bahao113/Xe-tu-hanh-OpenCV/Hinh anh ket qua/chong nhieu ban tay.png

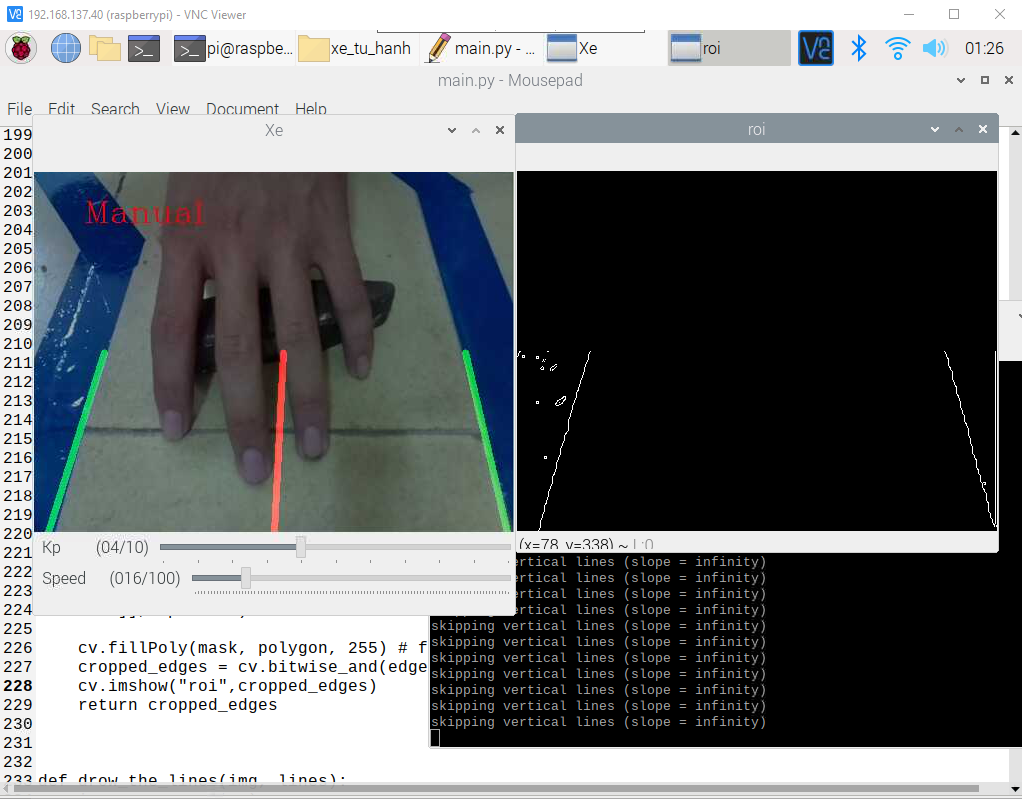
Hinh anh ket qua/chong nhieu ban tay.png
