bahao113/Xe-tu-hanh-OpenCV/Hinh anh ket qua/14bb37ee472dba73e33c.jpg

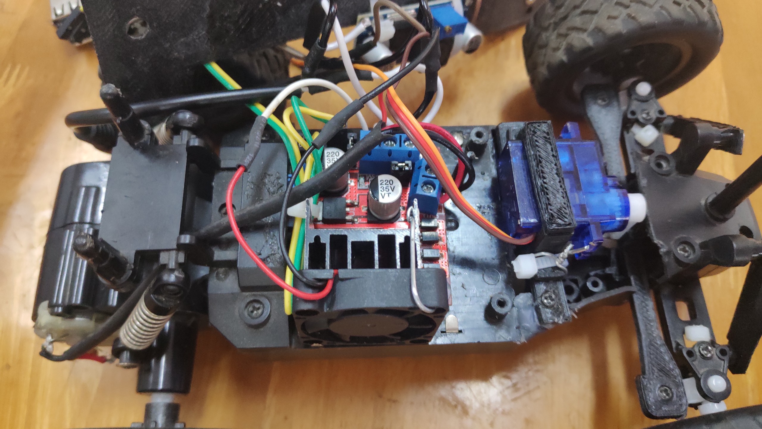
Hinh anh ket qua/14bb37ee472dba73e33c.jpg
