bahao113/Xe-tu-hanh-OpenCV/Hinh anh ket qua/3cb614c564069958c017.jpg

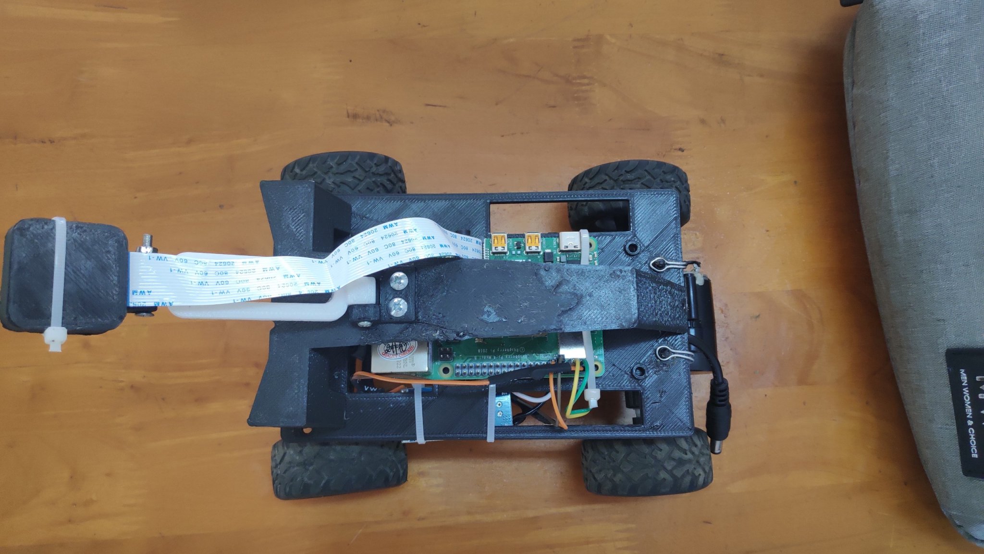
Hinh anh ket qua/3cb614c564069958c017.jpg
