bahao113/Xe-tu-hanh-OpenCV/Hinh anh ket qua/965b1f1d6fde9280cbcf.jpg

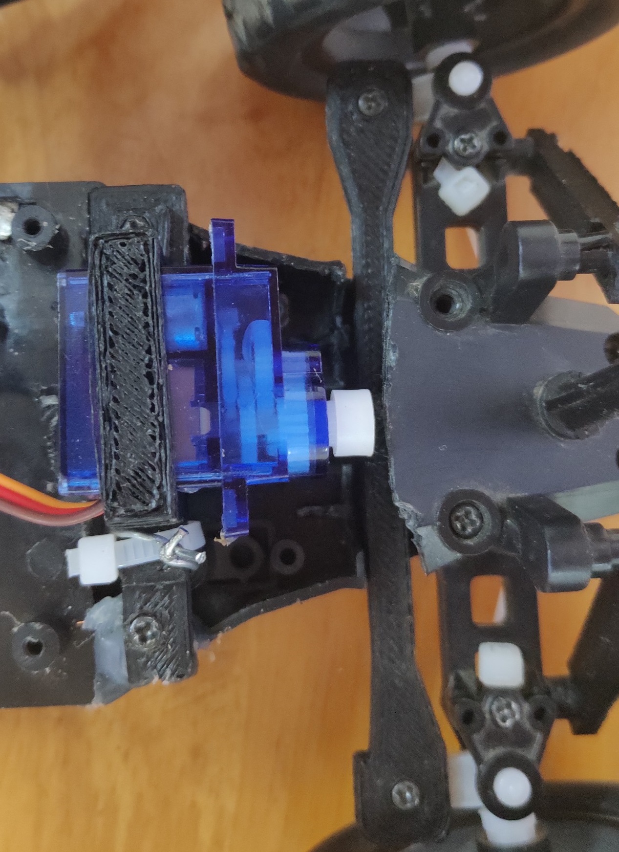
Hinh anh ket qua/965b1f1d6fde9280cbcf.jpg
