bahao113/Xe-tu-hanh-OpenCV/Hinh anh ket qua/chong nhieu.png

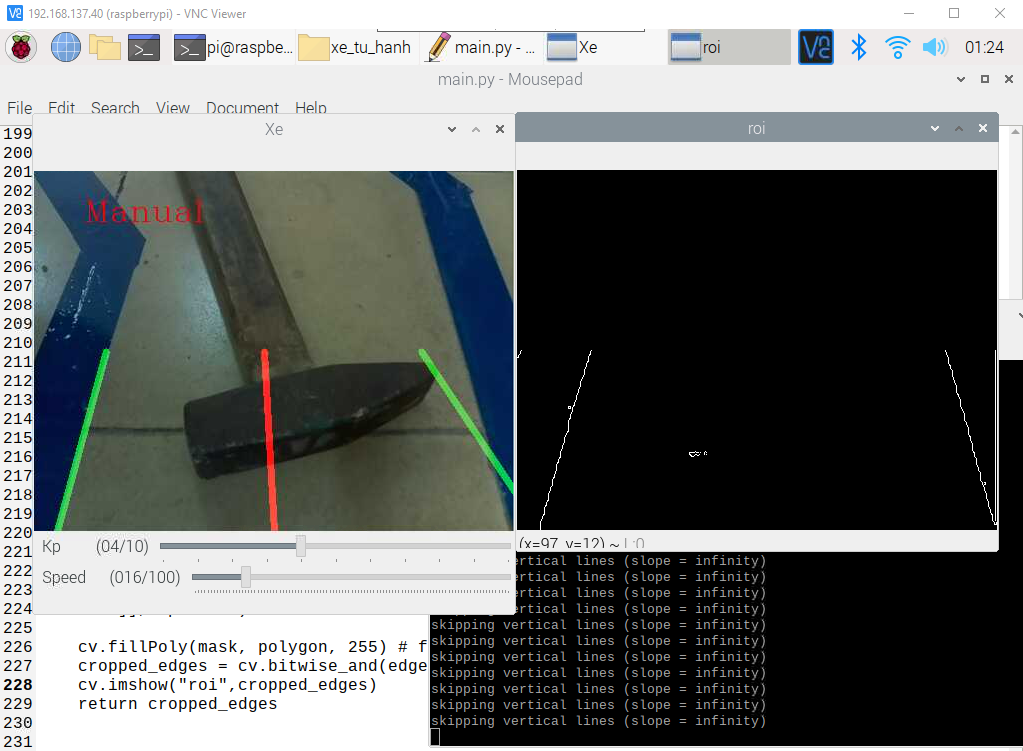
Hinh anh ket qua/chong nhieu.png
