bahao113/Xe-tu-hanh-OpenCV/Hinh anh ket qua/IMG_20200621_121812_1.jpg

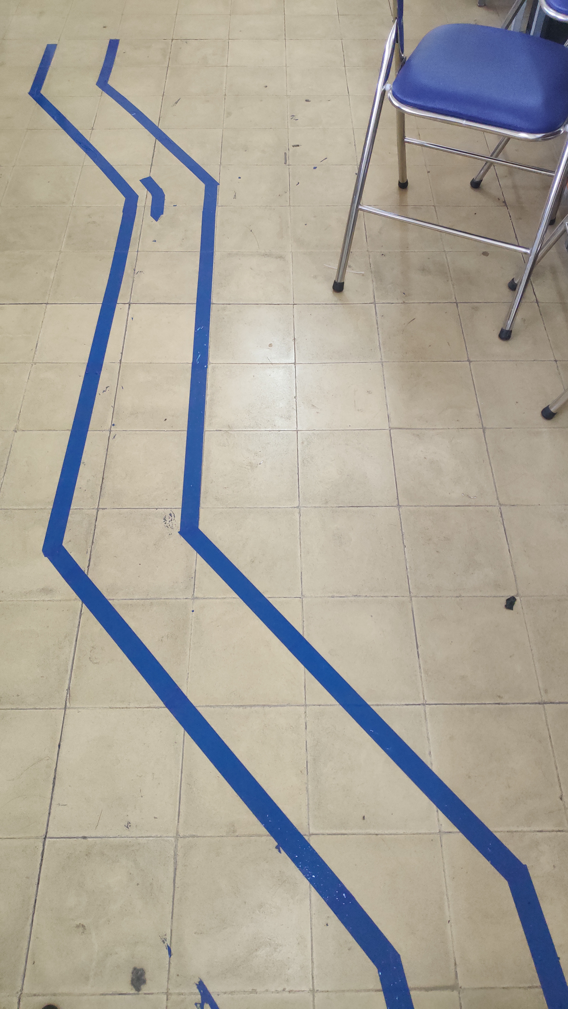
Hinh anh ket qua/IMG_20200621_121812_1.jpg
