bahao113/Xe-tu-hanh-OpenCV/Hinh anh Sketchup/camera_bed.png

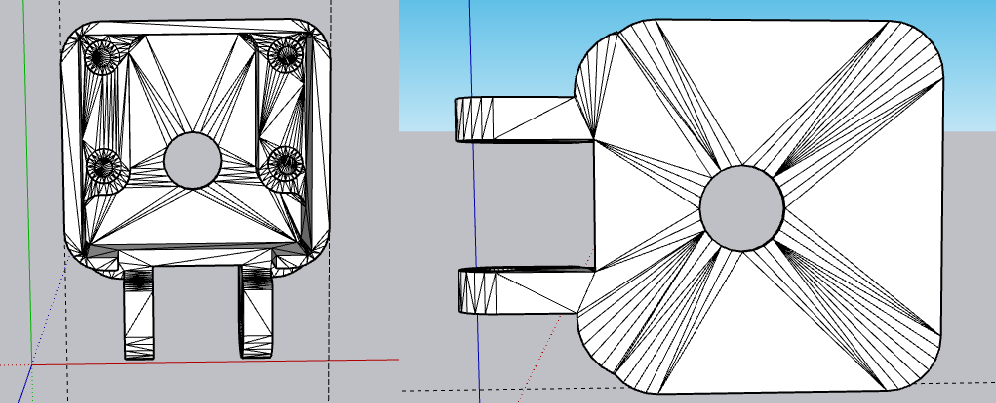
Hinh anh Sketchup/camera_bed.png
