bahao113/Xe-tu-hanh-OpenCV/Hinh anh Sketchup/canny, houghline, drawline.png

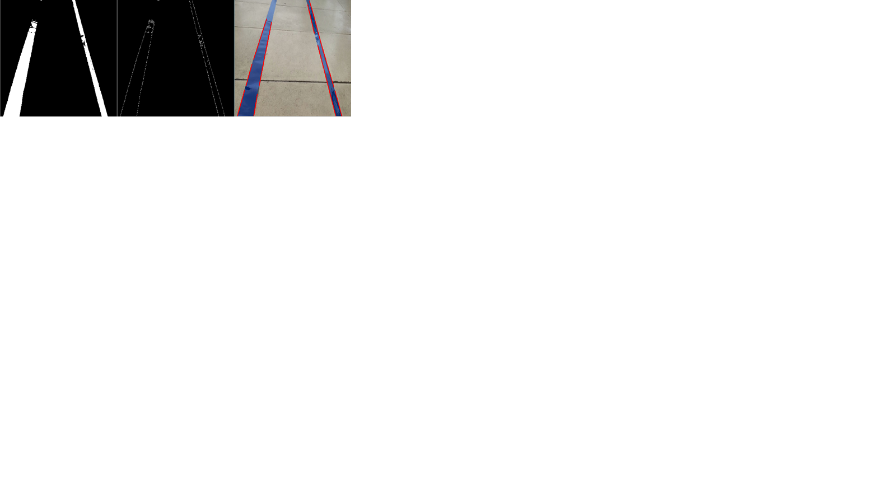
Hinh anh Sketchup/canny, houghline, drawline.png
