bahao113/Xe-tu-hanh-OpenCV/schematic/He thong dien.png

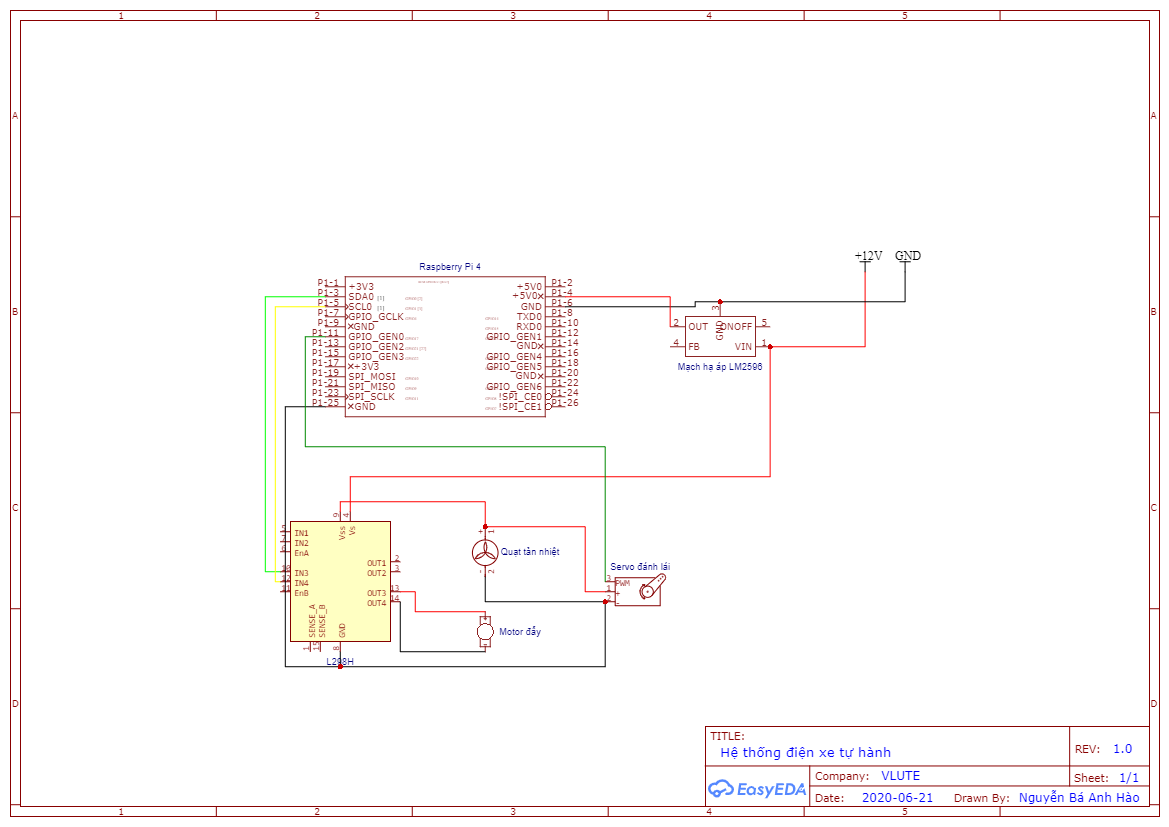
schematic/He thong dien.png
