bahao113/Xe-tu-hanh-OpenCV/schematic/so do.PNG

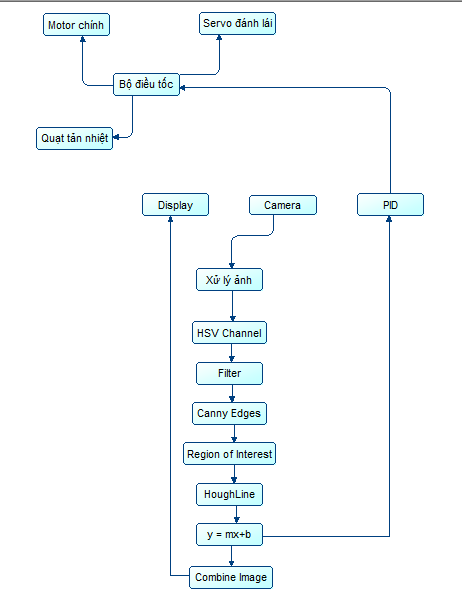
schematic/so do.PNG
