bahao113/Xe-tu-hanh-OpenCV/In 3d/Camera_Mount_Back_Cover.stl

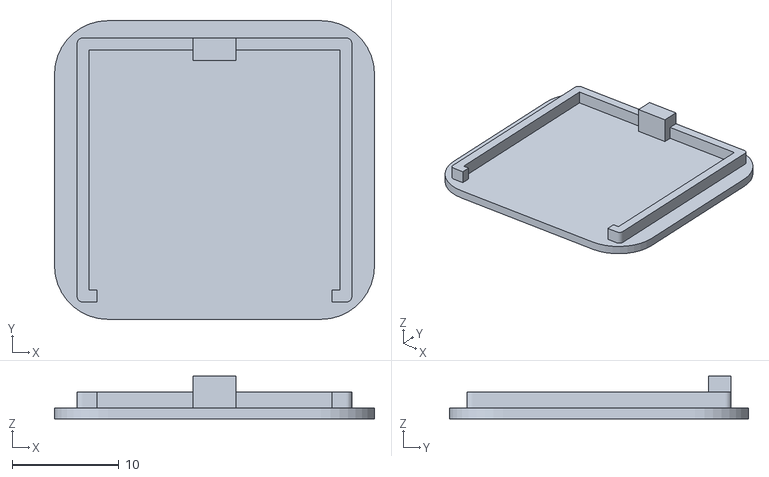
[picture p62: CAD file, 2020-06-21]
In 3d/Camera_Mount_Back_Cover.stl
30.0 x 28.0 x 4.00
