bahao113/Xe-tu-hanh-OpenCV/In 3d/steering bar new.stl

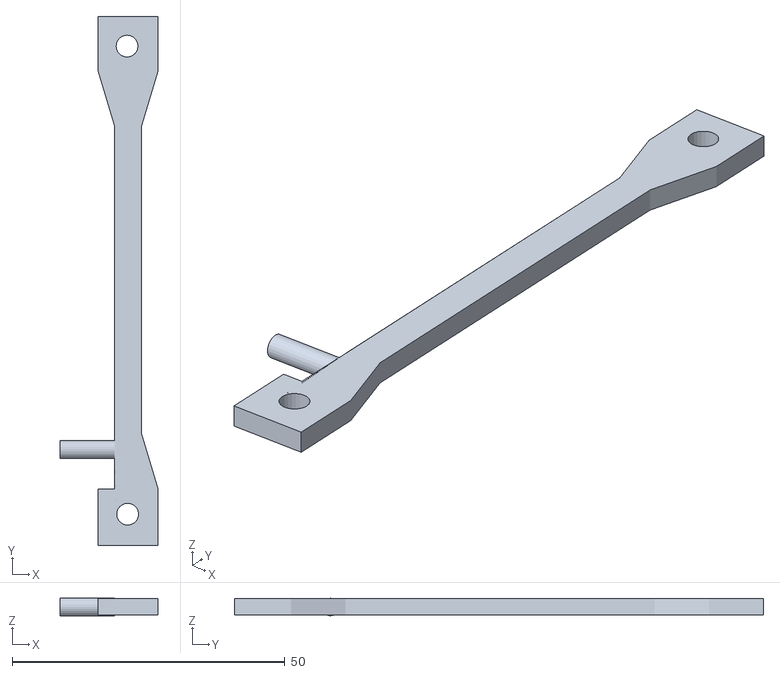
[picture p63: CAD file, 2020-06-21]
In 3d/steering bar new.stl
18.0 x 97.0 x 3.24
