bahao113/Xe-tu-hanh-OpenCV/In 3d/bed servo.stl

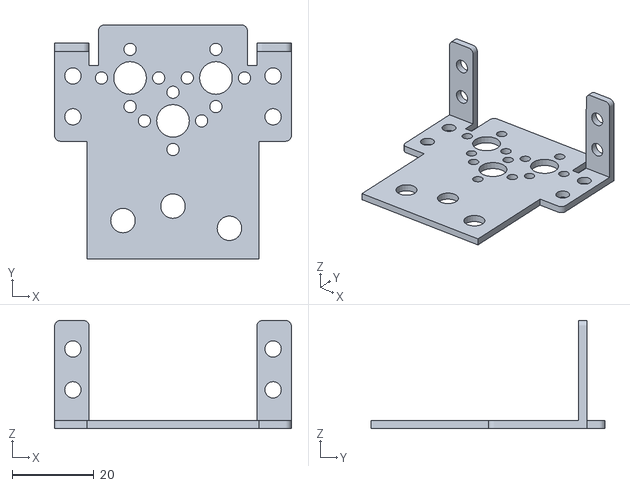
[picture p64: CAD file, 2020-06-21]
In 3d/bed servo.stl
58.0 x 57.3 x 26.5
