bahao113/Xe-tu-hanh-OpenCV/In 3d/Camera_Stand_Base.stl

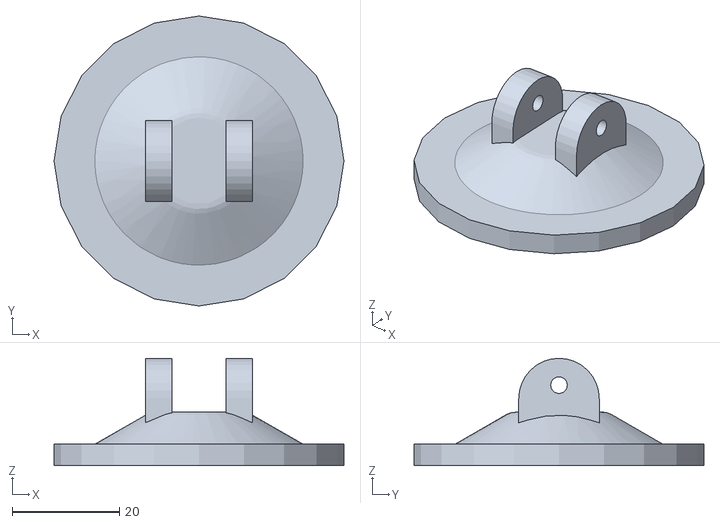
[picture p65: CAD file, 2020-06-21]
In 3d/Camera_Stand_Base.stl
54.0 x 54.0 x 20.0
