bahao113/Xe-tu-hanh-OpenCV/In 3d/test.stl

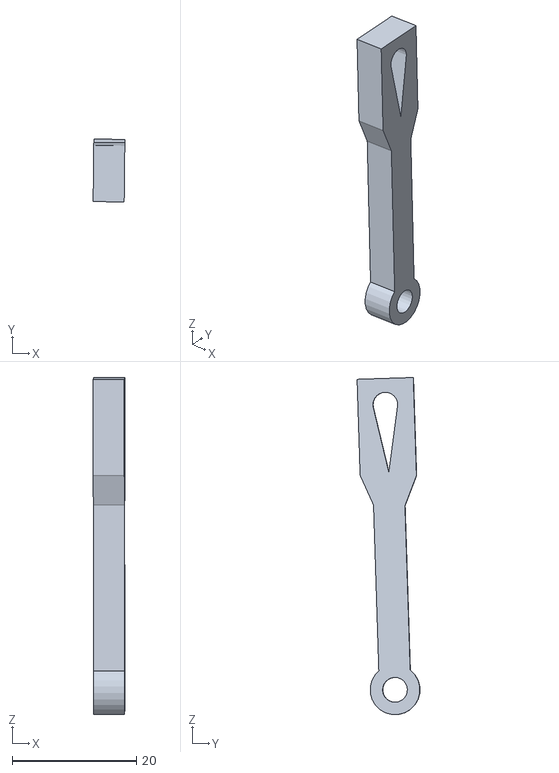
[picture p66: CAD file, 2020-06-21]
In 3d/test.stl
5.11 x 10.1 x 54.2
