bahao113/Xe-tu-hanh-OpenCV/In 3d/khung gan.stl

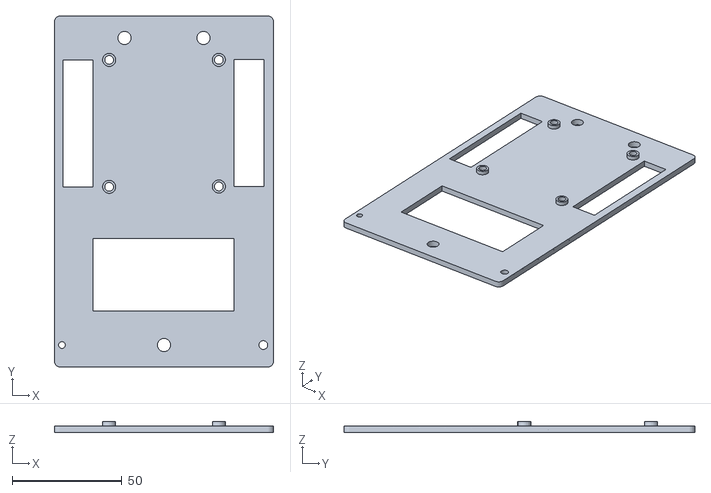
[picture p67: CAD file, 2020-06-21]
In 3d/khung gan.stl
100.0 x 160.0 x 5.00
