bahao113/Xe-tu-hanh-OpenCV/In 3d/new steering bar.stl

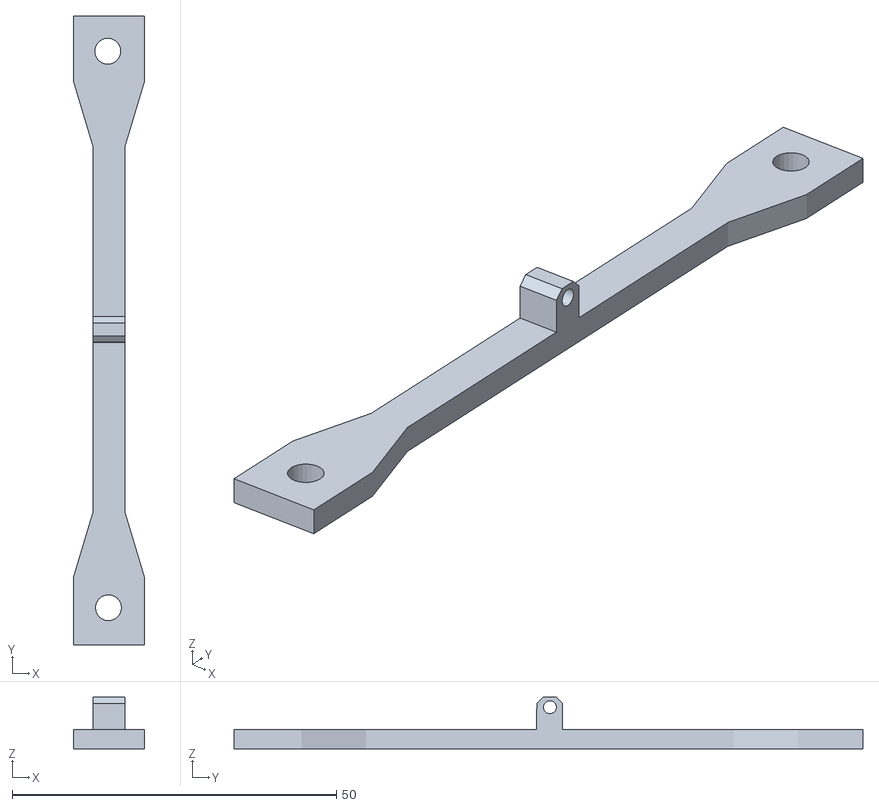
[picture p68: CAD file, 2020-06-21]
In 3d/new steering bar.stl
11.0 x 97.0 x 8.01
