bahao113/Xe-tu-hanh-OpenCV/In 3d/steering bar.stl

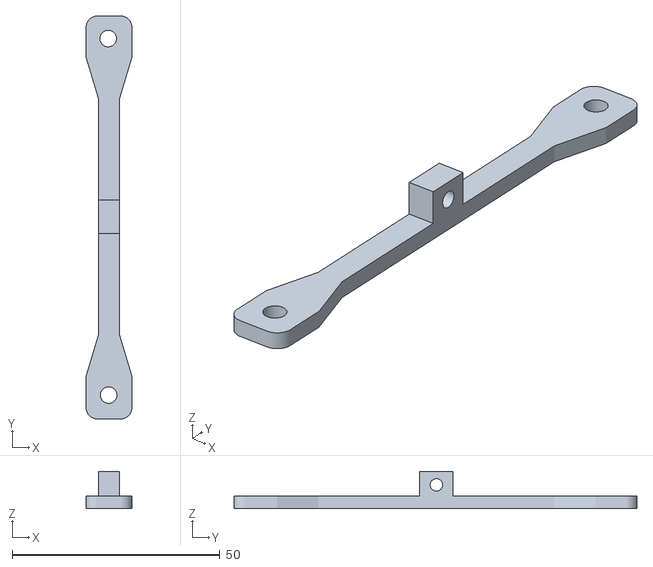
[picture p69: CAD file, 2020-06-21]
In 3d/steering bar.stl
11.0 x 97.0 x 9.01
