bahao113/Xe-tu-hanh-OpenCV/In 3d/Raspberry_PI_Camera_Stand.stl

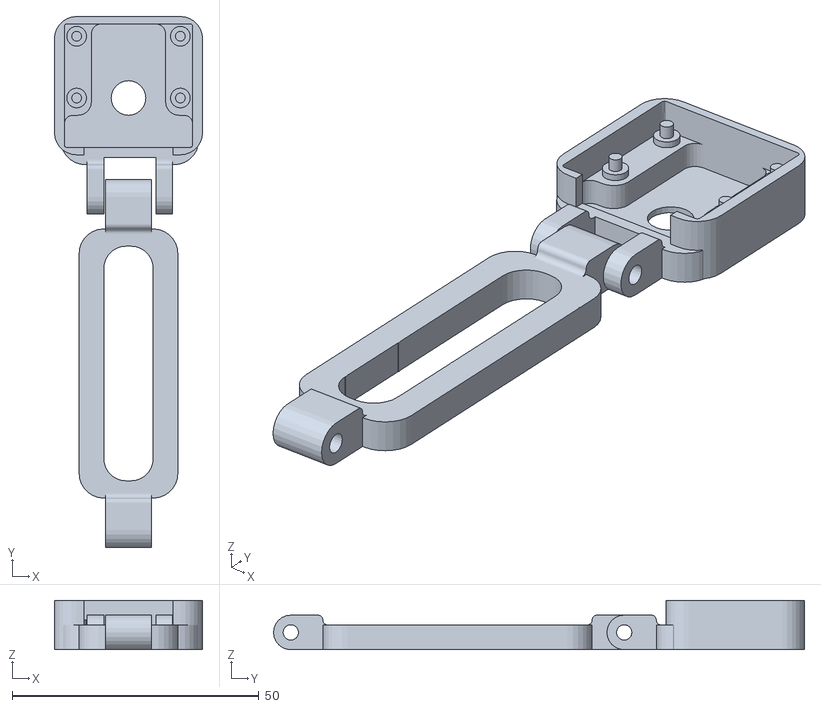
[picture p70: CAD file, 2020-06-21]
In 3d/Raspberry_PI_Camera_Stand.stl
30.0 x 107.5 x 10.0
