bahao113/Xe-tu-hanh-OpenCV/In 3d/nap servor.stl

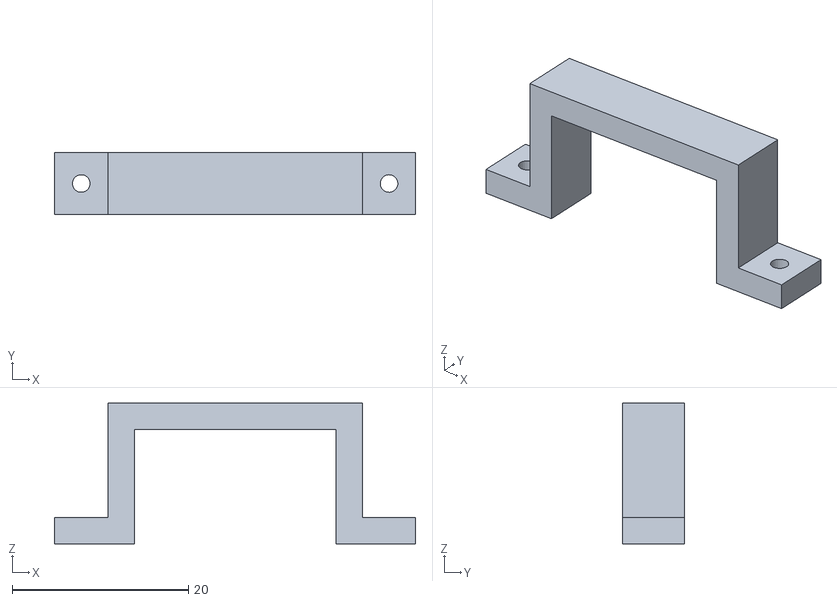
[picture p71: CAD file, 2020-06-21]
In 3d/nap servor.stl
41.0 x 7.00 x 16.0
