bahao113/Xe-tu-hanh-OpenCV/In 3d/piston.stl

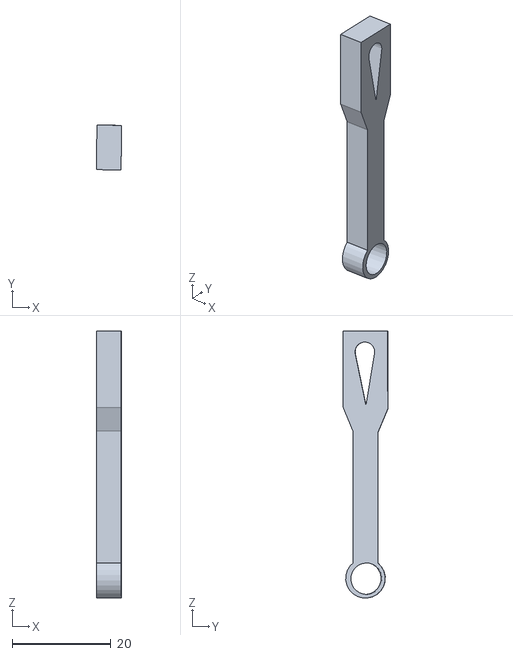
[picture p72: CAD file, 2020-06-21]
In 3d/piston.stl
5.10 x 9.09 x 54.1
