bahao113/Xe-tu-hanh-OpenCV/In 3d/pi camera bed.stl

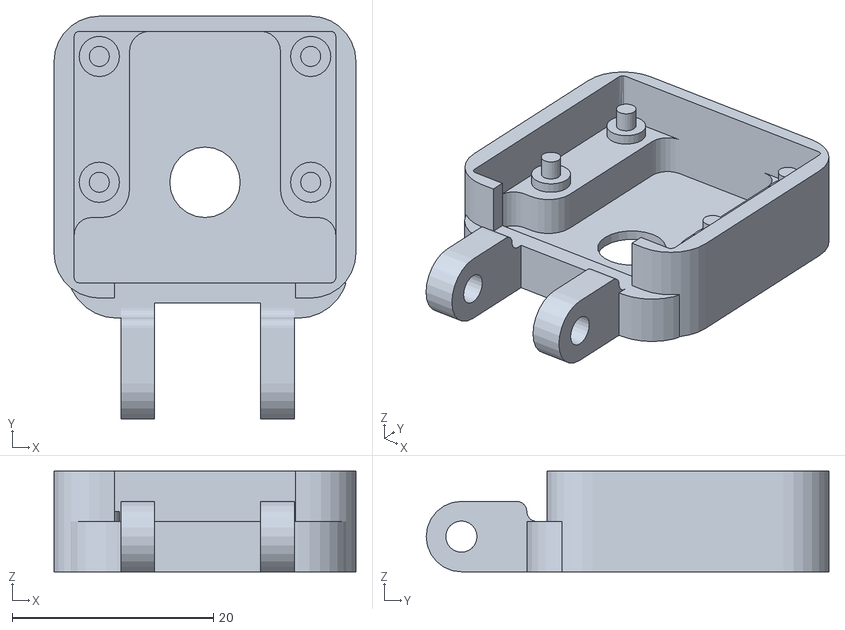
[picture p73: CAD file, 2020-06-21]
In 3d/pi camera bed.stl
30.0 x 40.0 x 10.0
