bahao113/Xe-tu-hanh-OpenCV/In 3d/donkey cage.stl

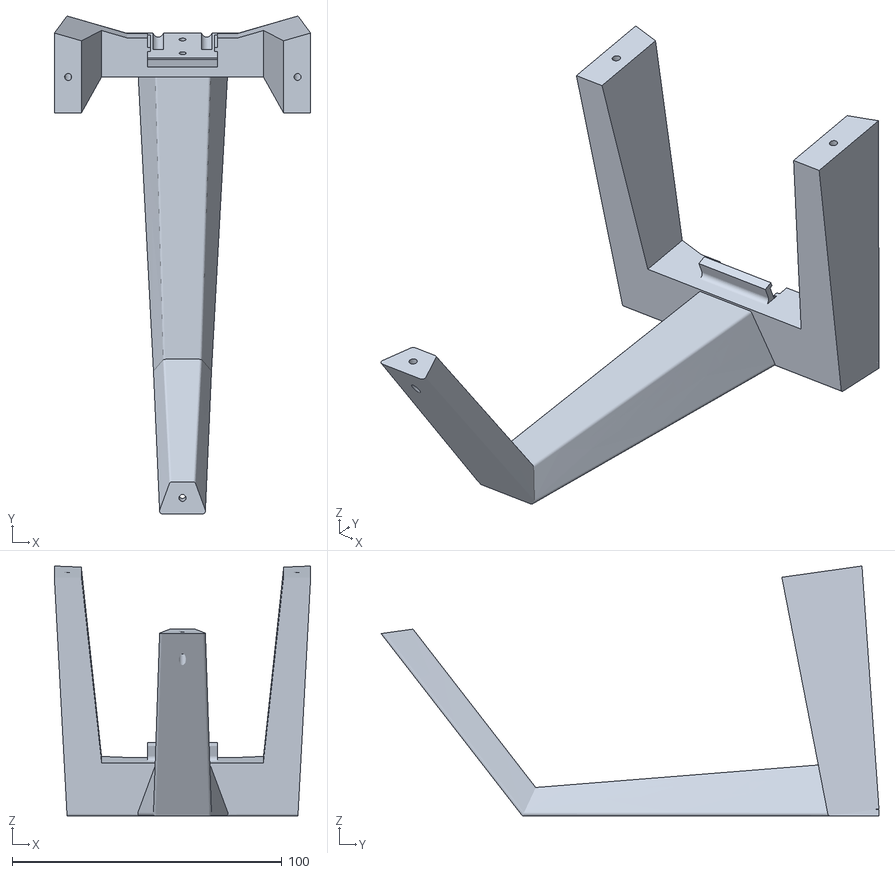
[picture p74: CAD file, 2020-06-21]
In 3d/donkey cage.stl
95.0 x 184.6 x 92.6
