bahao113/Xe-tu-hanh-OpenCV/(list of files, cad)

Other CAD files:
In 3d/nap servor.skp
In 3d/pi camera bed.skp
In 3d/piston.skp
In 3d/steering bar.skp
